leslier7/ece5160-fast-robotics/README.md

# ECE5160 

## Description
This repo contains all my source code and website files for Cornell University’s ECE 5160: Fast Robots.
