leslier7/ece5160-fast-robotics/docs/src/assets/headshot.jpg

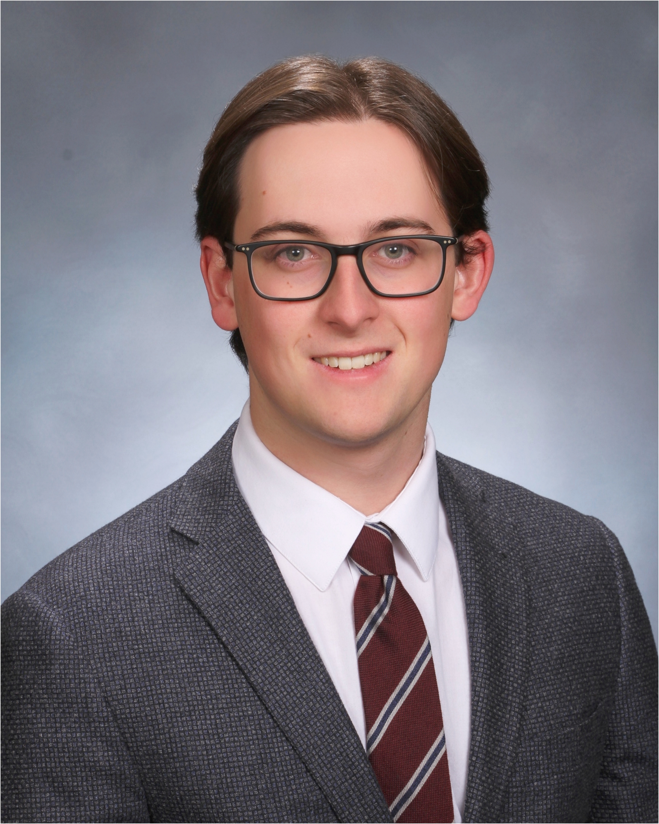
docs/src/assets/headshot.jpg
