leslier7/ece5160-fast-robotics/docs/src/assets/lab4-cover.jpg

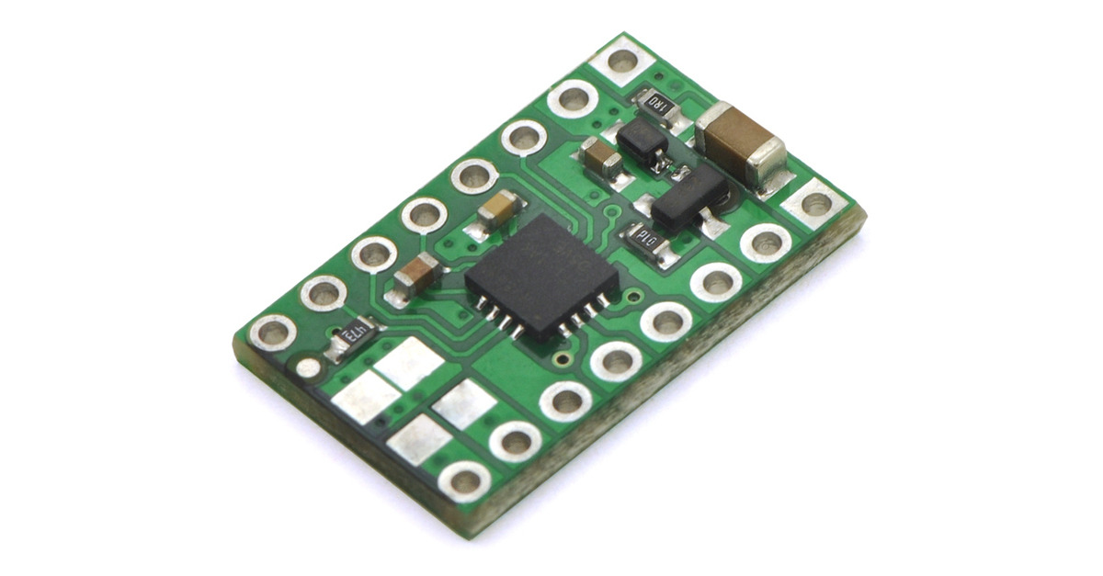
docs/src/assets/lab4-cover.jpg
