leslier7/ece5160-fast-robotics/docs/src/assets/lab6-cover.jpg

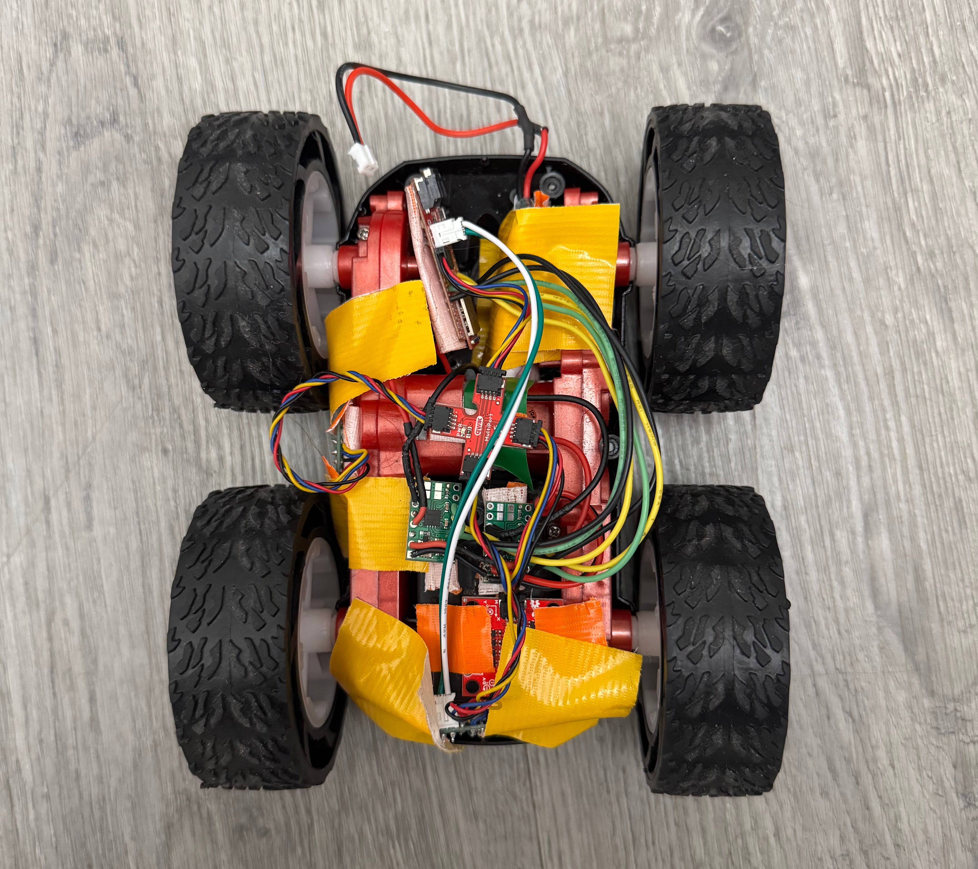
docs/src/assets/lab6-cover.jpg
