leslier7/ece5160-fast-robotics/docs/src/assets/lab7-cover.png

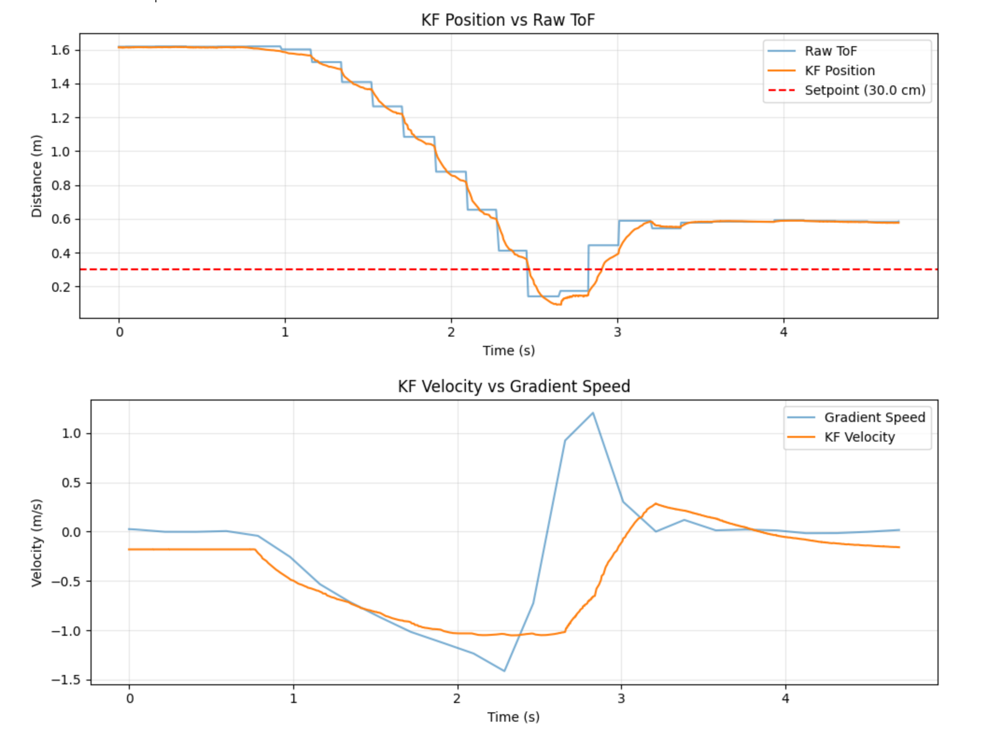
docs/src/assets/lab7-cover.png
