leslier7/ece5160-fast-robotics/docs/src/assets/lab10-cover.png

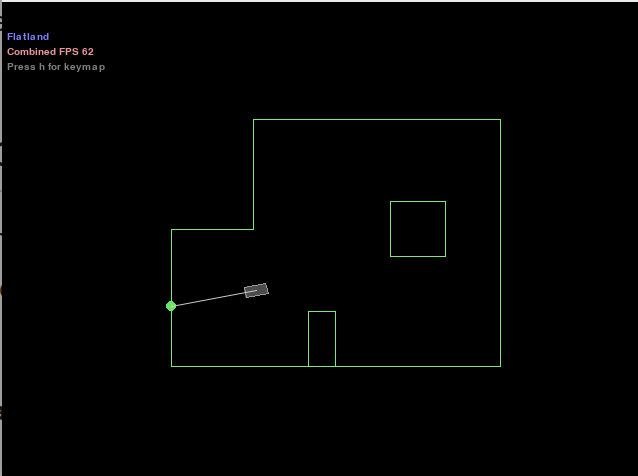
docs/src/assets/lab10-cover.png
