leslier7/ece5160-fast-robotics/docs/src/assets/lab12-cover.jpg

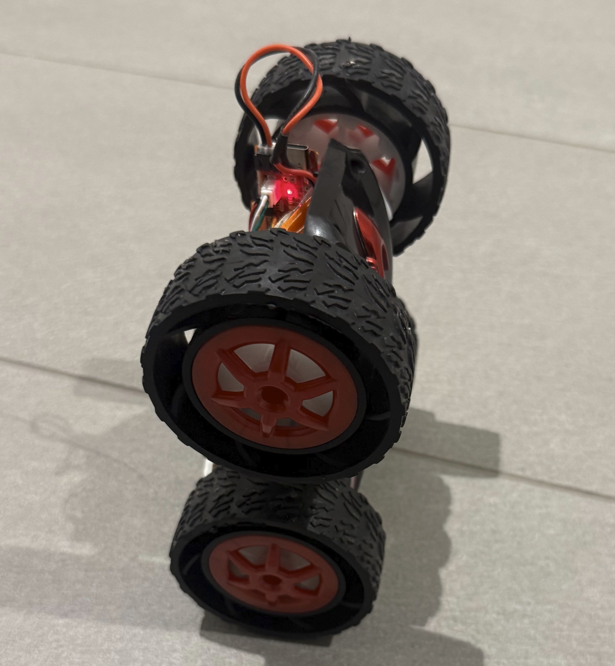
docs/src/assets/lab12-cover.jpg
