leslier7/ece5160-fast-robotics/jupyter_notebooks/ble_data_rate.png

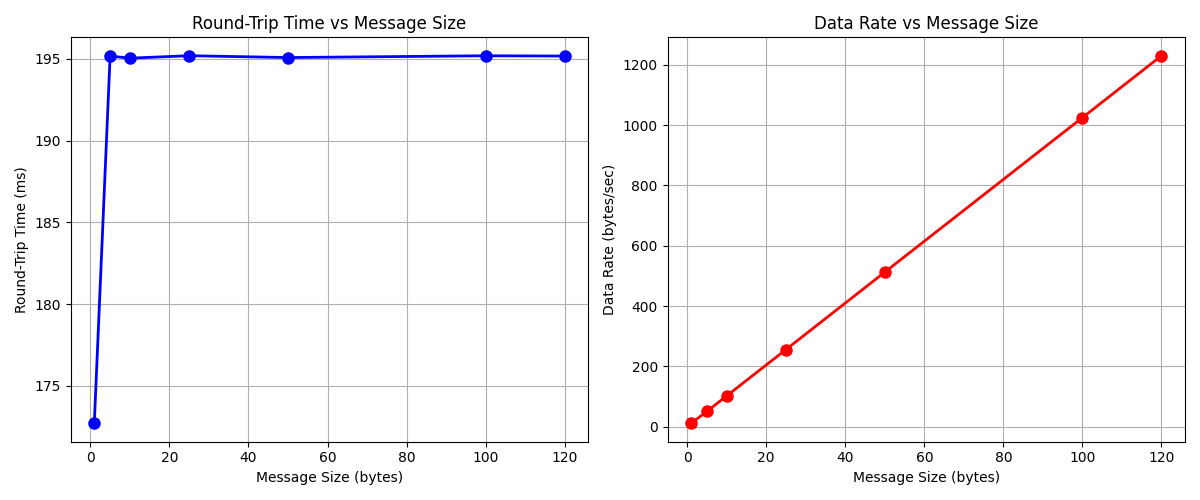
jupyter_notebooks/ble_data_rate.png
