leslier7/ece5160-fast-robotics/ble_arduino/src/commands.cpp

#include "commands.h"
#include "ble_config.h"
#include "globals.h"
#include "data_collection.h"
#include "debug.h"
#include "motor_functions.h"
#include "pid.h"
#include "drift.h"
#include "mapping.h"
#include "imu_functions.h"

static void send_mapping_data();
static bool handle_ping();
static bool handle_send_two_ints();
static bool handle_send_three_floats();
static bool handle_echo();
static bool handle_dance();
static bool handle_set_vel();
static bool handle_get_time_millis();
static bool handle_send_time_data();
static bool handle_get_temp_readings();
static bool handle_data_rate();
static bool handle_get_imu_readings();
static bool handle_start_recording();
static bool handle_stop_recording();
static bool handle_get_dist_readings();
static bool handle_get_all_readings();
static bool handle_set_motor_job();
static bool handle_set_motor_sequence();
static bool handle_set_pid_values();
static bool handle_set_setpoint();
static bool handle_start_pid();
static bool handle_stop_pid();
static bool handle_get_drive_data();
static bool handle_do_drift();
static bool handle_collect_mapping_data();

void
handle_command()
{   
    // Set the command string from the characteristic value
    robot_cmd.set_cmd_string(rx_characteristic_string.value(),
                             rx_characteristic_string.valueLength());

    bool success;
    int cmd_type = -1;

    // Get robot command type (an integer)
    /* NOTE: THIS SHOULD ALWAYS BE CALLED BEFORE get_next_value()
     * since it uses strtok internally (refer RobotCommand.h and 
     * https://www.cplusplus.com/reference/cstring/strtok/)
     */
    success = robot_cmd.get_command_type(cmd_type);

    // Check if the last tokenization was successful and return if failed
    if (!success) {
        return;
    }

    // Handle the command type accordingly
    switch (cmd_type) {
        /*
         * Write "PONG" on the GATT characteristic BLE_UUID_TX_STRING
         */
        case PING:
            handle_ping();
            break;
        /*
         * Extract two integers from the command string
         */
        case SEND_TWO_INTS:
            handle_send_two_ints();
            break;
        /*
         * Extract three floats from the command string
         */
        case SEND_THREE_FLOATS:
            handle_send_three_floats();
            break;
        /*
         * Add a prefix and postfix to the string value extracted from the command string
         */
        case ECHO:
            handle_echo();
            break;
        /*
         * DANCE
         */
        case DANCE:
            handle_dance();
            break;
        /*
         * SET_VEL
         */
        case SET_VEL:
            handle_set_vel();
            break;
        case GET_TIME_MILLIS:
            handle_get_time_millis();
            break;
        case SEND_TIME_DATA:
            handle_send_time_data();
            break;
        case GET_TEMP_READINGS:
            handle_get_temp_readings();
            break;
        case DATA_RATE:
            handle_data_rate();
            break;
        case GET_IMU_READINGS:
            handle_get_imu_readings();
            break;
        case START_RECORDING:
            handle_start_recording();
            break;
        case STOP_RECORDING:
            handle_stop_recording();
            break;
        case GET_DIST_READINGS:
            handle_get_dist_readings();
            break;
        case GET_ALL_READINGS:
            handle_get_all_readings();
            break;
        case SET_MOTOR_JOB:
            handle_set_motor_job();
            break;
        case SET_MOTOR_SEQUENCE:
            handle_set_motor_sequence();
            break;
        case SET_PID_VALUES:
            handle_set_pid_values();
            break;
        case SET_SETPOINT:
            handle_set_setpoint();
            break;
        case START_PID:
            handle_start_pid();
            break;
        case STOP_PID:
            handle_stop_pid();
            break;
        case GET_DRIVE_DATA:
            handle_get_drive_data();
            break;
        case DO_DRIFT:
            handle_do_drift();
            break;
        case COLLECT_MAPPING_DATA:
            handle_collect_mapping_data();
            break;

        /*
         * The default case may not capture all types of invalid commands.
         * It is safer to validate the command string on the central device (in python)
         * before writing to the characteristic.
         */
        default:
            DEBUG_PRINT("Invalid Command Type: ");
            DEBUG_PRINTLN(cmd_type);
            break;
    }
}

static bool handle_ping() {
    tx_estring_value.clear();
    tx_estring_value.append("PONG");
    tx_characteristic_string.writeValue(tx_estring_value.c_str());

    DEBUG_PRINT("Sent back: ");
    DEBUG_PRINTLN(tx_estring_value.c_str());

    return true;
}

static bool handle_send_two_ints() {
    int int_a, int_b;
    bool success;

    // Extract the next value from the command string as an integer
    success = robot_cmd.get_next_value(int_a);
    if (!success)
        return false;

    // Extract the next value from the command string as an integer
    success = robot_cmd.get_next_value(int_b);
    if (!success)
        return false;

    DEBUG_PRINT("Two Integers: ");
    DEBUG_PRINT(int_a);
    DEBUG_PRINT(", ");
    DEBUG_PRINTLN(int_b);
    
    return true;
}

static bool handle_send_three_floats() {
    float float_a, float_b, float_c;
    bool success;

    // Extract first float from command string
    success = robot_cmd.get_next_value(float_a);
    if (!success)
        return false;

    // Extract second float from command string
    success = robot_cmd.get_next_value(float_b);
    if (!success)
        return false;

    // Extract third float from command string
    success = robot_cmd.get_next_value(float_c);
    if (!success)
        return false;

    DEBUG_PRINT("Three floats: ");
    DEBUG_PRINT(float_a);
    DEBUG_PRINT(", ");
    DEBUG_PRINT(float_b);
    DEBUG_PRINT(", ");
    DEBUG_PRINTLN(float_c);

    return true;
}

static bool handle_echo() {
    char char_arr[MAX_MSG_SIZE];
    bool success;

    // Extract the next value from the command string as a character array
    success = robot_cmd.get_next_value(char_arr);
    if (!success)
        return false;

    DEBUG_PRINT("ECHO: ");
    DEBUG_PRINTLN(char_arr);

    EString temp_string = EString();
    temp_string.clear();
    temp_string.append("Robot received: ");
    temp_string.append(char_arr);

    tx_estring_value.clear();
    tx_estring_value.append(temp_string.c_str());
    tx_characteristic_string.writeValue(tx_estring_value.c_str());
    
    return true;
}

static bool handle_dance() {
    DEBUG_PRINTLN("Look Ma, I'm Dancin'!");

    return true;
}

static bool handle_set_vel() {

    return true;
}

static bool handle_get_time_millis() {
    char char_arr[MAX_MSG_SIZE];

    snprintf(char_arr, MAX_MSG_SIZE, "T:%lu", millis());

    tx_estring_value.clear();
    tx_estring_value.append(char_arr);
    tx_characteristic_string.writeValue(tx_estring_value.c_str());

    return true;
}

static bool handle_send_time_data() {
    DEBUG_PRINTLN("Sending time data!");

    EString temp_string = EString();
    int tx_result = -1;

    recording = false; // Pause recording while transmitting
    int start = time_data.index;
    for(int k = 0; k < DATA_ARR_SIZE; k++){
        int i = (start + k) % DATA_ARR_SIZE; // chronological order
        
        char value_str[20];
        snprintf(value_str, sizeof(value_str), "%lu", time_data.values[i]);
        
        // Check if adding this value would exceed MAX_MSG_SIZE
        // Account for comma separator and null terminator
        int needed_len = strlen(value_str) + (temp_string.get_length() > 0 ? 1 : 0);
        
        if (temp_string.get_length() + needed_len >= MAX_MSG_SIZE - 1) {
            // Send current packet before it overflows
            tx_result = tx_characteristic_string.writeValue(temp_string.c_str());
            DEBUG_PRINT("Sent packet: ");
            DEBUG_PRINTLN(temp_string.c_str());
            
            // Small delay to allow BLE stack to process
            delay(10);
            
            // Reset for next packet
            temp_string.clear();
        }
        
        // Add comma if not first item in current packet
        if (temp_string.get_length() > 0) {
            temp_string.append(",");
        }
        temp_string.append(value_str);
    }

    // Send any remaining data
    if (temp_string.get_length() > 0) {
        tx_result = tx_characteristic_string.writeValue(temp_string.c_str());
        DEBUG_PRINT("Sent packet: ");
        DEBUG_PRINTLN(temp_string.c_str());
        delay(10);
    }

    // Send end marker
    tx_result = tx_characteristic_string.writeValue("end");
    DEBUG_PRINT("Serial Transmission Result: ");
    DEBUG_PRINTLN(tx_result);
    DEBUG_PRINTLN("Finished sending array");

    recording = true;

    return true;
}

static bool handle_get_temp_readings() {
    DEBUG_PRINTLN("Sending temp readings");

    EString temp_string = EString();
    int tx_result = -1;

    recording = false; // Pause recording while transmitting
    int start = temp_data.index;
    for(int k = 0; k < DATA_ARR_SIZE; k++){
        int i = (start + k) % DATA_ARR_SIZE; // chronological order


        char value_str[30];
        snprintf(value_str, sizeof(value_str), "%lu:%d", time_data.values[i], temp_data.values[i]);
        
        // Check if adding this value would exceed MAX_MSG_SIZE
        // Account for comma separator and null terminator
        int needed_len = strlen(value_str) + (temp_string.get_length() > 0 ? 1 : 0);
        
        if (temp_string.get_length() + needed_len >= MAX_MSG_SIZE - 1) {
            // Send current packet before it overflows
            tx_result = tx_characteristic_string.writeValue(temp_string.c_str());
            DEBUG_PRINT("Sent packet: ");
            DEBUG_PRINTLN(temp_string.c_str());
            
            // Small delay to allow BLE stack to process
            delay(10);
            
            // Reset for next packet
            temp_string.clear();
        }
        
        // Add comma if not first item in current packet
        if (temp_string.get_length() > 0) {
            temp_string.append(",");
        }
        temp_string.append(value_str);
    }

    // Send any remaining data
    if (temp_string.get_length() > 0) {
        tx_result = tx_characteristic_string.writeValue(temp_string.c_str());
        DEBUG_PRINT("Sent packet: ");
        DEBUG_PRINTLN(temp_string.c_str());
        delay(10);
    }

    // Send end marker
    tx_result = tx_characteristic_string.writeValue("end");
    DEBUG_PRINT("Serial Transmission Result: ");
    DEBUG_PRINTLN(tx_result);
    DEBUG_PRINTLN("Finished sending array");

    recording = true;

    return true;
}

static bool handle_data_rate() {
    int byte_size;
    bool success;

    // Extract first float from command string
    success = robot_cmd.get_next_value(byte_size);
    if (!success)
        return false;

    // Clamp to valid range
    if (byte_size >= MAX_MSG_SIZE) {
        byte_size = MAX_MSG_SIZE - 1;
    }

    // Fast string construction using memset
    char reply[MAX_MSG_SIZE];
    memset(reply, 'X', byte_size);
    reply[byte_size] = '\0';  // Null terminate

    // Send the message
    tx_characteristic_string.writeValue(reply);

    // Force immediate transmission
    BLE.poll();

    DEBUG_PRINT("Sent ");
    DEBUG_PRINT(byte_size);
    DEBUG_PRINTLN(" byte reply");

    return true;
}

static bool handle_get_imu_readings() {
    DEBUG_PRINTLN("Sending IMU readings");

    EString temp_string = EString();
    int tx_result = -1;


    recording = false; // Pause recording while transmitting
    int start = imu_data.index;
    for(int k = 0; k < DATA_ARR_SIZE; k++){
        int i = (start + k) % DATA_ARR_SIZE; // chronological order

        char value_str[30];
        snprintf(value_str, sizeof(value_str), "%lu:%.3f:%.3f:%.3f", time_data.values[i], imu_data.values[i].pitch, imu_data.values[i].roll, imu_data.values[i].yaw);
        
        // Check if adding this value would exceed MAX_MSG_SIZE
        // Account for comma separator and null terminator
        int needed_len = strlen(value_str) + (temp_string.get_length() > 0 ? 1 : 0);
        
        if (temp_string.get_length() + needed_len >= MAX_MSG_SIZE - 1) {
            // Send current packet before it overflows
            tx_result = tx_characteristic_string.writeValue(temp_string.c_str());
            DEBUG_PRINT("Sent packet: ");
            DEBUG_PRINTLN(temp_string.c_str());
            
            // Small delay to allow BLE stack to process
            delay(10);
            
            // Reset for next packet
            temp_string.clear();
        }
        
        // Add comma if not first item in current packet
        if (temp_string.get_length() > 0) {
            temp_string.append(",");
        }
        temp_string.append(value_str);
    }

    // Send any remaining data
    if (temp_string.get_length() > 0) {
        tx_result = tx_characteristic_string.writeValue(temp_string.c_str());
        DEBUG_PRINT("Sent packet: ");
        DEBUG_PRINTLN(temp_string.c_str());
        delay(10);
    }

    // Send end marker
    tx_result = tx_characteristic_string.writeValue("end");
    DEBUG_PRINT("Serial Transmission Result: ");
    DEBUG_PRINTLN(tx_result);
    DEBUG_PRINTLN("Finished sending array");

    recording = true; // Resume recording after transmit
    return true;
}

static bool handle_start_recording() {
    clearData(time_data);
    clearData(temp_data);
    clearData(imu_data);

    clearData(yaw_data);
    clearData(dist_data);
    clearData(motor_data);
    recording = true;

    EString temp_string = EString();
    temp_string.clear();
    temp_string.append("Started recording");

    tx_estring_value.clear();
    tx_estring_value.append(temp_string.c_str());
    tx_characteristic_string.writeValue(tx_estring_value.c_str());

    return true;
}

static bool handle_stop_recording() {
    recording = false;
    EString temp_string = EString();
    temp_string.clear();
    temp_string.append("Stopped recording");

    tx_estring_value.clear();
    tx_estring_value.append(temp_string.c_str());
    tx_characteristic_string.writeValue(tx_estring_value.c_str());

    return true;
}

static bool handle_get_dist_readings() {
    DEBUG_PRINTLN("Sending all readings");

    EString temp_string = EString();
    int tx_result = -1;


    recording = false; // Pause recording while transmitting
    int start = dist_data.index;
    for(int k = 0; k < DATA_ARR_SIZE; k++){
        int i = (start + k) % DATA_ARR_SIZE; // chronological order

        char value_str[30];
        snprintf(value_str, sizeof(value_str), "%lu:%d:%d", time_data.values[i], dist_data.values[i].front, dist_data.values[i].side);
        
        // Check if adding this value would exceed MAX_MSG_SIZE
        // Account for comma separator and null terminator
        int needed_len = strlen(value_str) + (temp_string.get_length() > 0 ? 1 : 0);
        
        if (temp_string.get_length() + needed_len >= MAX_MSG_SIZE - 1) {
            // Send current packet before it overflows
            tx_result = tx_characteristic_string.writeValue(temp_string.c_str());
            DEBUG_PRINT("Sent packet: ");
            DEBUG_PRINTLN(temp_string.c_str());
            
            // Small delay to allow BLE stack to process
            delay(10);
            
            // Reset for next packet
            temp_string.clear();
        }
        
        // Add comma if not first item in current packet
        if (temp_string.get_length() > 0) {
            temp_string.append(",");
        }
        temp_string.append(value_str);
    }

    // Send any remaining data
    if (temp_string.get_length() > 0) {
        tx_result = tx_characteristic_string.writeValue(temp_string.c_str());
        DEBUG_PRINT("Sent packet: ");
        DEBUG_PRINTLN(temp_string.c_str());
        delay(10);
    }

    // Send end marker
    tx_result = tx_characteristic_string.writeValue("end");
    DEBUG_PRINT("Serial Transmission Result: ");
    DEBUG_PRINTLN(tx_result);
    DEBUG_PRINTLN("Finished sending array");

    recording = true; // Resume recording after transmit
    return true;
}

static bool handle_get_all_readings() {
    DEBUG_PRINTLN("Sending all readings");

    //Stop motors when sending values
    stopBothMotors();
    abortMotorQueue(true);

    EString temp_string = EString();
    int tx_result = -1;


    recording = false; // Pause recording while transmitting
    int start = dist_data.index;
    for(int k = 0; k < DATA_ARR_SIZE; k++){
        int i = (start + k) % DATA_ARR_SIZE; // chronological order

        char value_str[64];
        snprintf(value_str, sizeof(value_str), "%lu:%.3f:%.3f:%.3f:%d:%d:%.3f:%.3f", time_data.values[i], imu_data.values[i].pitch, imu_data.values[i].roll, imu_data.values[i].yaw, dist_data.values[i].front, dist_data.values[i].side, motor_data.values[i].left_percent, motor_data.values[i].right_percent);

        // Check if adding this value would exceed MAX_MSG_SIZE
        // Account for comma separator and null terminator
        int needed_len = strlen(value_str) + (temp_string.get_length() > 0 ? 1 : 0);
        
        if (temp_string.get_length() + needed_len >= MAX_MSG_SIZE - 1) {
            // Send current packet before it overflows
            tx_result = tx_characteristic_string.writeValue(temp_string.c_str());
            DEBUG_PRINT("Sent packet: ");
            DEBUG_PRINTLN(temp_string.c_str());
            
            // Small delay to allow BLE stack to process
            delay(10);
            
            // Reset for next packet
            temp_string.clear();
        }
        
        // Add comma if not first item in current packet
        if (temp_string.get_length() > 0) {
            temp_string.append(",");
        }
        temp_string.append(value_str);
    }

    // Send any remaining data
    if (temp_string.get_length() > 0) {
        tx_result = tx_characteristic_string.writeValue(temp_string.c_str());
        DEBUG_PRINT("Sent packet: ");
        DEBUG_PRINTLN(temp_string.c_str());
        delay(10);
    }

    // Send end marker
    tx_result = tx_characteristic_string.writeValue("end");
    DEBUG_PRINT("Serial Transmission Result: ");
    DEBUG_PRINTLN(tx_result);
    DEBUG_PRINTLN("Finished sending array");

    recording = true; // Resume recording after transmit
    return true;
}

static bool handle_set_motor_job() {
    float right_percent, left_percent;
    int duration_ms_i;
    bool success;
    char char_arr[MAX_MSG_SIZE];

    // Extract first float from command string
    success = robot_cmd.get_next_value(left_percent);
    if (!success)
        return false;

    // Extract second float from command string
    success = robot_cmd.get_next_value(right_percent);
    if (!success)
        return false;

    // Extract third float from command string
    success = robot_cmd.get_next_value(duration_ms_i);
    if (!success)
        return false;

    if (duration_ms_i < 0) duration_ms_i = 0; // bounds checking just in case
    uint32_t duration_ms = (uint32_t)duration_ms_i;

    DEBUG_PRINTF("Left percent: %f   Right percent: %f   duration (ms): %d\n", left_percent, right_percent, duration_ms);

    snprintf(char_arr, MAX_MSG_SIZE, "l:%f,r:%f,d:%d", left_percent, right_percent, duration_ms);

    EString temp_string = EString();
    temp_string.clear();
    temp_string.append("Robot received: ");
    temp_string.append(char_arr);

    tx_estring_value.clear();
    tx_estring_value.append(temp_string.c_str());
    tx_characteristic_string.writeValue(tx_estring_value.c_str());

    startMotorJob(right_percent, left_percent, duration_ms); // Start after the bluetooth return msg so that doesnt interfere
    startMotorQueue();

    return true;
}

static bool handle_set_motor_sequence() {
    float right_percent, left_percent;
    int duration_ms_i;
    bool success;
    int jobs_queued = 0;

    abortMotorQueue(true); //Clear the current queue

    // Keep reading triplets until we run out of tokens
    while (true) {
        success = robot_cmd.get_next_value(left_percent);
        if (!success) break;

        success = robot_cmd.get_next_value(right_percent);
        if (!success) break;

        success = robot_cmd.get_next_value(duration_ms_i);
        if (!success) break;

        if (duration_ms_i < 0) duration_ms_i = 0;
        uint32_t duration_ms = (uint32_t)duration_ms_i;

        DEBUG_PRINTF("Left percent: %f   Right percent: %f   duration (ms): %d\n", left_percent, right_percent, duration_ms);

        

        if (!queueMotorJob(right_percent, left_percent, duration_ms)) { //Shouldn't hit the error state, but still
            DEBUG_PRINTLN("Motor queue full!");
            break;
        }
        jobs_queued++;
    }

    // Send back how many jobs were queued
    char char_arr[MAX_MSG_SIZE];
    snprintf(char_arr, MAX_MSG_SIZE, "Queued %d motor jobs", jobs_queued);
    tx_estring_value.clear();
    tx_estring_value.append(char_arr);
    tx_characteristic_string.writeValue(tx_estring_value.c_str());

    startMotorQueue();

    return jobs_queued > 0;
}

bool handle_set_pid_values(){
    float kp, ki, kd, alpha, windup_max;
    bool success;
    bool alpha_changed = false;
    bool windup_changed = false;
    char char_arr[MAX_MSG_SIZE];

    success = robot_cmd.get_next_value(kp);
    if (!success)
        return false;

    success = robot_cmd.get_next_value(ki);
    if (!success)
        return false;

    success = robot_cmd.get_next_value(kd);
    if (!success)
        return false;

    // This one is optional
    success = robot_cmd.get_next_value(alpha);
    if (!success){
        DEBUG_PRINTLN("Alpha not changed");
    } else {
        alpha_changed = true;
    }

    // This one is optional
    success = robot_cmd.get_next_value(windup_max);
    if (!success){
        DEBUG_PRINTLN("Max windup not changed");
    } else {
        windup_changed = true;
    }

    if(!alpha_changed && !windup_changed){
        snprintf(char_arr, MAX_MSG_SIZE, "p:%f,i:%f,d:%f", kp, ki, kd);
    } else if(alpha_changed && !windup_changed){
        snprintf(char_arr, MAX_MSG_SIZE, "p:%f,i:%f,d:%f,a:%f", kp, ki, kd, alpha);
    } else if(!alpha_changed && windup_changed){
        snprintf(char_arr, MAX_MSG_SIZE, "p:%f,i:%f,d:%f,w_m:%f", kp, ki, kd, windup_max); // This should never happen
    } else {
        snprintf(char_arr, MAX_MSG_SIZE, "p:%f,i:%f,d:%f,a:%f,w_m:%f", kp, ki, kd, alpha, windup_max); 
    }
    

    EString temp_string = EString();
    temp_string.clear();
    temp_string.append("Robot received: ");
    temp_string.append(char_arr);

    tx_estring_value.clear();
    tx_estring_value.append(temp_string.c_str());
    tx_characteristic_string.writeValue(tx_estring_value.c_str());

    #ifdef STUNT
    if(!alpha_changed && !windup_changed){
        changePIDValues(imu_pid, kp, ki, kd);
    } else if(alpha_changed && !windup_changed){
        changePIDValues(imu_pid, kp, ki, kd, alpha);
    } else if(!alpha_changed && windup_changed){
        changePIDValues(imu_pid, kp, ki, kd, imu_pid.alpha, windup_max); //This should never happen
    } else {
        changePIDValues(imu_pid, kp, ki, kd, alpha, windup_max); 
    }
    #else
    if(!alpha_changed && !windup_changed){
        changePIDValues(pid_controller, kp, ki, kd);
    } else if(alpha_changed && !windup_changed){
        changePIDValues(pid_controller, kp, ki, kd, alpha);
    } else if(!alpha_changed && windup_changed){
        changePIDValues(pid_controller, kp, ki, kd, pid_controller.alpha, windup_max); //This should never happen
    } else {
        changePIDValues(pid_controller, kp, ki, kd, alpha, windup_max); 
    }
    #endif
    return true;
}

bool handle_set_setpoint(){
    float setpoint;
    bool success;
    char char_arr[MAX_MSG_SIZE];

    // Extract first setpoint from command string
    success = robot_cmd.get_next_value(setpoint);
    if (!success)
        return false;

    snprintf(char_arr, MAX_MSG_SIZE, "sp:%f", setpoint);
    
    

    EString temp_string = EString();
    temp_string.clear();
    temp_string.append("Robot received: ");
    temp_string.append(char_arr);

    tx_estring_value.clear();
    tx_estring_value.append(temp_string.c_str());
    tx_characteristic_string.writeValue(tx_estring_value.c_str());

    #ifdef TOF
    setpoint = setpoint * 10; // cm to mm
    #endif

    setSetpoint(pid_controller, setpoint);

    return true;
}

bool handle_start_pid(){
    bool success;
    // char char_arr[MAX_MSG_SIZE];

    // snprintf(char_arr, MAX_MSG_SIZE, "sp:%f", setpoint);
    
    

    EString temp_string = EString();
    temp_string.clear();
    temp_string.append("Starting PID control");
    //temp_string.append(char_arr);

    tx_estring_value.clear();
    tx_estring_value.append(temp_string.c_str());
    tx_characteristic_string.writeValue(tx_estring_value.c_str());

    startPID(pid_controller);

    return true;
}

bool handle_stop_pid(){
    bool success;
    // char char_arr[MAX_MSG_SIZE];

    // snprintf(char_arr, MAX_MSG_SIZE, "sp:%f", setpoint);

    EString temp_string = EString();
    temp_string.clear();
    temp_string.append("Stopping PID control");
    //temp_string.append(char_arr);

    tx_estring_value.clear();
    tx_estring_value.append(temp_string.c_str());
    tx_characteristic_string.writeValue(tx_estring_value.c_str());

    stopPID(pid_controller);
    stopBothMotors(); // if stopping PID, also stop the motors

    return true;
}

//Send yaw, ToF values, and motor values
bool handle_get_drive_data(){
    DEBUG_PRINTLN("Sending drive readings");

    //Stop motors when sending values
    stopBothMotors();
    abortMotorQueue(true);

    // Stop both sensors while transmitting
    distanceSensorFront.stopRanging();
    distanceSensorSide.stopRanging();

    EString temp_string = EString();
    int tx_result = -1;


    recording = false; // Pause recording while transmitting

    // Send setpoint once
    char setpoint_str[32];
    #ifdef STUNT
    snprintf(setpoint_str, sizeof(setpoint_str), "setpoint:%.3f", imu_pid.setpoint);
    #else
    snprintf(setpoint_str, sizeof(setpoint_str), "setpoint:%.3f", pid_controller.setpoint);
    #endif
    tx_result = tx_characteristic_string.writeValue(setpoint_str);
    DEBUG_PRINT("Sent setpoint packet: ");
    DEBUG_PRINTLN(setpoint_str);
    delay(10);

    int start = dist_data.index;
    for(int k = 0; k < DATA_ARR_SIZE; k++){
        int i = (start + k) % DATA_ARR_SIZE; // chronological order

        char value_str[64];
        snprintf(value_str, sizeof(value_str), "%lu:%.2f:%d:%d:%.2f:%.2f:%.2f:%.2f", time_data.values[i], yaw_data.value[i], dist_data.values[i].front, dist_data.values[i].side, motor_data.values[i].left_percent, motor_data.values[i].right_percent, kf_data.values[i].pos, kf_data.values[i].vel);

        // Check if adding this value would exceed MAX_MSG_SIZE
        // Account for comma separator and null terminator
        int needed_len = strlen(value_str) + (temp_string.get_length() > 0 ? 1 : 0);
        
        if (temp_string.get_length() + needed_len >= MAX_MSG_SIZE - 1) {
            // Send current packet before it overflows
            tx_result = tx_characteristic_string.writeValue(temp_string.c_str());
            DEBUG_PRINT("Sent packet: ");
            DEBUG_PRINTLN(temp_string.c_str());
            
            // Small delay to allow BLE stack to process
            delay(10);
            
            // Reset for next packet
            temp_string.clear();
        }
        
        // Add comma if not first item in current packet
        if (temp_string.get_length() > 0) {
            temp_string.append(",");
        }
        temp_string.append(value_str);
    }

    // Send any remaining data
    if (temp_string.get_length() > 0) {
        tx_result = tx_characteristic_string.writeValue(temp_string.c_str());
        DEBUG_PRINT("Sent packet: ");
        DEBUG_PRINTLN(temp_string.c_str());
        delay(10);
    }

    // Send end marker
    tx_result = tx_characteristic_string.writeValue("end");
    DEBUG_PRINT("Serial Transmission Result: ");
    DEBUG_PRINTLN(tx_result);
    DEBUG_PRINTLN("Finished sending array");

    recording = true; // Resume recording after transmit
    clearDriveData(time_data, yaw_data, dist_data, motor_data, kf_data);
    distanceSensorFront.startRanging();  // re-arm after BLE transmission
    distanceSensorSide.startRanging();
    return true;
}

bool handle_do_drift(){
    bool success;
    int bluetooth_drive_time;
    int bt_break_time;
    int bt_turn_angle;
    int bt_angle_zone;
    float bt_calibration_factor;
    
    // char char_arr[MAX_MSG_SIZE];

    // snprintf(char_arr, MAX_MSG_SIZE, "sp:%f", setpoint);

    success = robot_cmd.get_next_value(bluetooth_drive_time);
    if (!success)
        return false;

    success = robot_cmd.get_next_value(bt_break_time);
    if (!success)
        return false;

    success = robot_cmd.get_next_value(bt_turn_angle);
    if (!success)
        return false;

    success = robot_cmd.get_next_value(bt_angle_zone);
    if (!success)
        return false;

    success = robot_cmd.get_next_value(bt_calibration_factor);
    if (!success)
        return false;

    EString temp_string = EString();
    temp_string.clear();
    temp_string.append("Doing drift");
    //temp_string.append(char_arr);

    tx_estring_value.clear();
    tx_estring_value.append(temp_string.c_str());
    tx_characteristic_string.writeValue(tx_estring_value.c_str());

    drive_time = bluetooth_drive_time;
    break_time = bt_break_time;
    turn_angle = bt_turn_angle;
    angle_zone = bt_angle_zone;

    calibration_factor = bt_calibration_factor;

    stopPID(pid_controller);
    abortMotorQueue(true);
    startDrift();

    return true;
}

bool handle_collect_mapping_data(){
    stopPID(pid_controller);
    abortMotorQueue(true);
    startMapping();

    // Block here while the state machine runs, keeping BLE and yaw alive
    static unsigned long prev_status_ms = 0;
    while(mapping_running) {
        updateYaw(&yaw, myICM);
        mappingStateTick();
        BLE.poll();

        if (millis() - prev_status_ms >= 500) {
            const char* state_str =
                (MappingState == MAPPING_TURN)    ? "TURN" :
                (MappingState == MAPPING_COLLECT) ? "COLLECT" : "START";
            float yaw_error = mapping_pid.setpoint - yaw;
            if (yaw_error >  180.0f) yaw_error -= 360.0f;
            if (yaw_error < -180.0f) yaw_error += 360.0f;
            char status[64];
            snprintf(status, sizeof(status), "STATUS:%s:y=%.1f:sp=%.1f:e=%.1f:pts=%d",
                     state_str, yaw, mapping_pid.setpoint, yaw_error, points_collected);
            tx_characteristic_string.writeValue(status);
            prev_status_ms = millis();
        }
    }

    stopBothMotors();
    send_mapping_data();
    return true;
}

static void send_mapping_data(){
    EString temp_string = EString();
    int tx_result = -1;

    for(int i = 0; i < points_collected; i++){
        char value_str[32];
        snprintf(value_str, sizeof(value_str), "%.3f:%.1f", map_data[i].yaw, map_data[i].distance);

        int needed_len = strlen(value_str) + (temp_string.get_length() > 0 ? 1 : 0);
        if (temp_string.get_length() + needed_len >= MAX_MSG_SIZE - 1) {
            tx_result = tx_characteristic_string.writeValue(temp_string.c_str());
            delay(10);
            temp_string.clear();
        }

        if (temp_string.get_length() > 0) {
            temp_string.append(",");
        }
        temp_string.append(value_str);
    }

    if (temp_string.get_length() > 0) {
        tx_result = tx_characteristic_string.writeValue(temp_string.c_str());
        delay(10);
    }

    tx_characteristic_string.writeValue("end");
    DEBUG_PRINTLN("Finished sending mapping data");
}
