leslier7/ece5160-fast-robotics/ble_arduino/include/mapping.h

#ifndef MAPPING_H
#define MAPPING_H

#include "pid.h"

enum MappingStates{
    MAPPING_START,
    MAPPING_TURN,
    MAPPING_COLLECT,
    MAPPING_END
};

extern bool mapping_running;
extern int points_collected;

extern MappingStates MappingState;
extern PIDController mapping_pid;

void startMapping();

void mappingStateTick();

#endif
