leslier7/ece5160-fast-robotics/(commit log)

2026-02-09 Sending IMU array (and massive refactor)
2026-02-25 Updated wiring diagram
2026-03-03 Basic motor control
2026-03-09 Added PID over Bluetooth
2026-03-09 Python Bluetooth PID control
2026-03-09 Continued work on PID tuning
2026-03-24 Working on KF filter sim
2026-04-22 Updated the PID controller
