leslier7/ece5160-fast-robotics/docs/public/assets/lab12/balancestanding.jpg

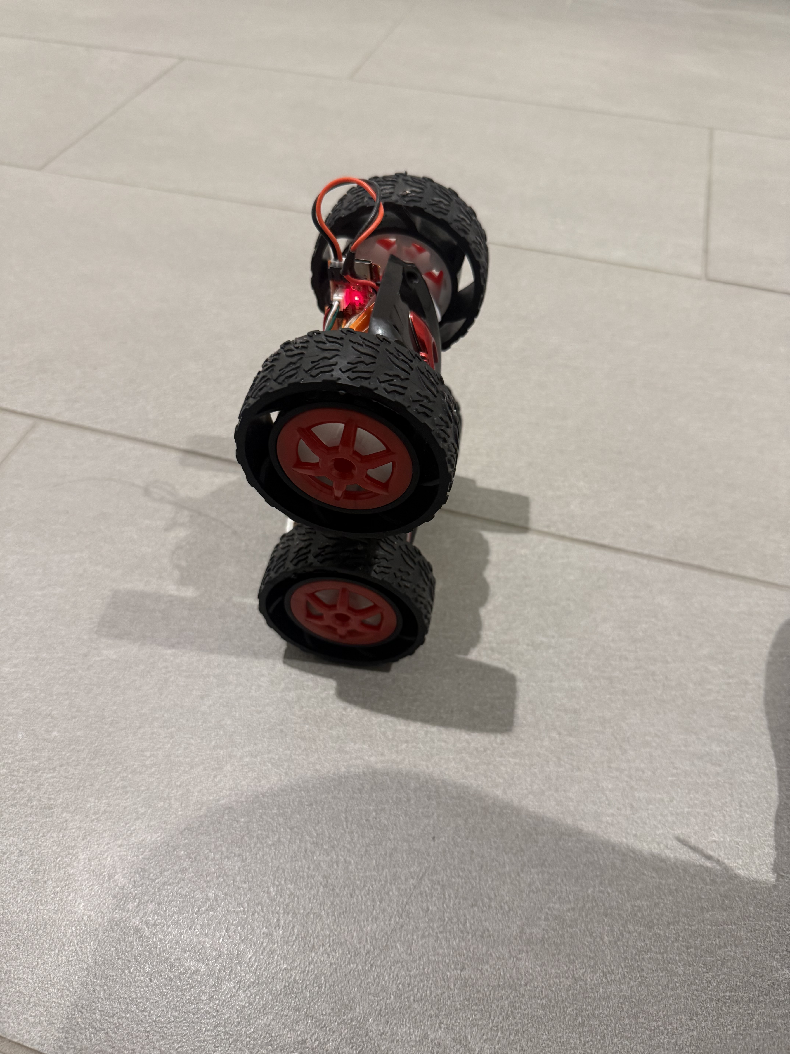
[picture p1: docs/public/assets/lab12/balancestanding.jpg]
docs/public/assets/lab12/balancestanding.jpg
