leslier7/ece5160-fast-robotics/docs/public/assets/lab4/CalibrationCarPOV.jpg

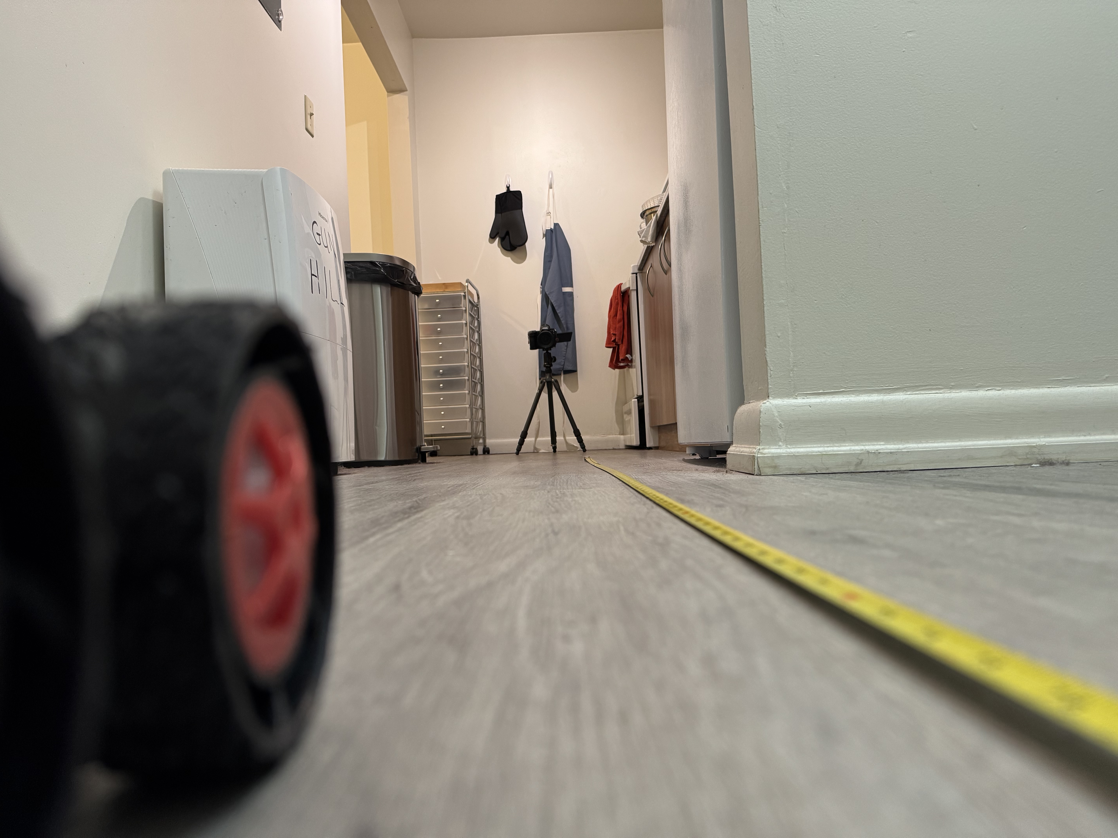
[picture p38: docs/public/assets/lab4/CalibrationCarPOV.jpg]
docs/public/assets/lab4/CalibrationCarPOV.jpg
